CrazyRedMachine/UltimatePopnController/(commit log)

2020-07-04 Leonardo EEPROM + linguist-vendored fix
    [POPNHID.cpp, popnWithKeypad.ino]
2020-08-09 ezusb driver and optional devicepath.dat
2021-08-22 custom vid/pid, hid strings
2021-08-22 automatic device detection with VID/PID
